chochavo/FunctionGeneratorIot/Schematics/Communication Protocol.xlsx

 | Commands - WLAN Communication Sequence
Step | Description | Command | Response | Direction
1 | ESP32 AT Commands Set | <According to Datasheet | \r\nOK\r\n | Device -> ESP32
2 | Request Wi-Fi from EEPROM | WN=S<SSID>,P<PASS>,E<ENCRYPTION>\r\n | \r\nOK\r\n | Device -> Device
 | Commands - Socket Message Handler (SMH)
 | Description | Command | Response | Direction
 | Battery Status [%] | \r\nGIVE BAT\r\n | VBAT=<VALUE>\r\n | Phone -> Device
 | AC Status | \r\nGIVE AC\r\n | AC=ON\r\n (OR) AC=OFF\r\n | Phone -> Device
 | Boot from direct mode | \r\nBOOT=DIR\r\n | \r\nOK\r\n | Phone -> Device
 | Boot from local Wi-Fi | \r\nBOOT=LAN\r\n | \r\nOK\r\n | Phone -> Device
 | Reset device | \r\nBOOT=RESET\r\n | \r\nOK\r\n | Phone -> Device
 | Factory settings | \r\nBOOT=RESTORE\r\n | \r\nOK\r\n | Phone -> Device
 | Shut down device | \r\nBOOT=SHDN\r\n | \r\nOK\r\n | Phone -> Device
 | Set LCD Brightness | \r\nLCD=B100\r\n | \r\nOK\r\n | Phone -> Device
 | Set LCD Contrast | \r\nLCD=C100\r\n | \r\nOK\r\n | Phone -> Device
 | Set Volume | \r\nVOL=100\r\n | \r\nOK\r\n | Phone -> Device
 | Commands - Set device parameter | Format | \r\nC=<CHANNEL>,<PARAMETER>="<WORD>"\r\n
 | Description | Command | Response | Direction
 | Set Bias - CH1, NEGATIVE | \r\nC=1,B="-1.00"\r\n | \r\nOK\r\n | Phone -> Device
 | Set Bias - CH0, POSITIVE | \r\nC=0,B="+2.33"\r\n | \r\nOK\r\n | Phone -> Device
 | Set Amplitude - CH1 | \r\nC=1,A="0.55"\r\n | \r\nOK\r\n | Phone -> Device
 | Set Amplitude - CH0 | \r\nC=0,A="1.00"\r\n | \r\nOK\r\n | Phone -> Device
 | Set Frequency - CH1 | \r\nC=1,F="1000000"\r\n | \r\nOK\r\n | Phone -> Device
 | Set Frequency - CH0 | \r\nC=0,F="10"\r\n | \r\nOK\r\n | Phone -> Device
 | Set Type - CH1, SINE | \r\nC=1,T="S"'\r\n | \r\nOK\r\n | Phone -> Device
 | Set Type - CH1, TRIANGLE | \r\nC=1,T="T"\r\n | \r\nOK\r\n | Phone -> Device
 | Set Type - CH1, SQUARE | \r\nC=1,T="Q'\r\n | \r\nOK\r\n | Phone -> Device
 | Set Type - CH1, DC | \r\nC=1,T="D"\r\n | \r\nOK\r\n | Phone -> Device
 | Set Type - CH1, OFF | \r\nC=1,T="O"\r\n | \r\nOK\r\n | Phone -> Device
 | Commands - Misc | Format | \r\nC=<CHANNEL>,<PARAMETER>="<WORD>"\r\n
 | Description | Command | Response | Direction
 | Reboot request for ARTIK055 | RESET\r\n | \r\nOK\r\n | Device -> Phone
 | Shutdown Sequence | SHDN\r\n | \r\nOK\r\n | Device -> Phone
