chochavo/FunctionGeneratorIot/Schematics/BOM.xls

UI Parts
 | Description | Quantity
 | 2004A Char-LCD 20x4 Blue | 1
 | USB Type B Connector | 1
 | 10 Set Mini Micro JST XH 2.54mm 4 Pin | 1
 | 6pcs Momentary SW | 1
Main PCB
 | Ref. Des. | Value | Part Number | Mouser Part Number | Quantity | Price | Ext. Price
 | C3, C8, C11, C12, C15, C16, C17, C18, C19, C20, C21, C24, C25, C26, C27, C30, C32, C35, C36, C37, C38, C39, C40, C41, C42, C43, C44 | 0.1uF | GCD21BR72A104KA01L | 81-GCD21BR72A104KA1L | 30 | 0.26 | 7.80
 | J3, J5 | X | 1-1337543-0 | 571-1-1337543-0 | 4 | 1.45 | 5.80
 | R2 | 1M | CRCW08051M13FKEA | 71-CRCW08051M13FKEA | 5 | 0.10 | 0.50
 | C1, C5, C7, C9, C13, C22, C31 | 1uF | 885012107015 | 710-885012107015 | 10 | 0.10 | 1.00
 | R1 | 3K | CR0805-FX-3321ELF | 652-CR0805FX-3321ELF | 5 | 0.10 | 0.50
 | R15, R24 | 5K6 | ERJ-6ENF5601V | 667-ERJ-6ENF5601V | 5 | 0.10 | 0.50
 | R6, R26, R27, R28, R31, R32, R33, R36, R37, R38, R43, R44, R45, R46, R47, R48, R49, R50, R51, R52, R53 | 10K | ERJ-6ENF1002V | 667-ERJ-6ENF1002V | 40 | 0.10 | 4.00
 | C14, C23 | 10nF | 885342207005 | 710-885342207005 | 5 | 0.10 | 0.50
 | C2, C4, C6 | 10uF | TAJA106M006RNJ | 581-TAJA106M006R | 6 | 0.26 | 1.56
 | R41, R42 | 20K | ESR10EZPJ203 | 755-ESR10EZPJ203 | 5 | 0.10 | 0.50
 | C28, C29 | 22pF | 885012007002 | 710-885012007002 | 5 | 0.10 | 0.50
 | R4 | 39K | ERJ-6ENF3902V | 667-ERJ-6ENF3902V | 5 | 0.10 | 0.50
 | C33, C34 | 47uF | TAJA476K006SNJV | 581-TAJA476K006SNJV | 5 | 0.53 | 2.65
 | R5 | 56K | CR0805-JW-563ELF | 652-CR0805JW-563ELF | 5 | 0.10 | 0.50
 | R29, R30 | 100K | ERJ-6ENF1003V | 667-ERJ-6ENF1003V | 5 | 0.10 | 0.50
 | R39, R40 | 100R | CRCW0805100RJNEAC | 71-CRCW0805100RJNEAC | 5 | 0.10 | 0.50
 | R25 | 180R | RC0805JR-13180RL | 603-RC0805JR-13180RL | 5 | 0.11 | 0.55
 | R8, R9, R17, R18 | 200R | CR0805-FX-2000ELF | 652-CR0805FX-2000ELF | 8 | 0.10 | 0.80
 | R13, R22 | 470R | CR0805-JW-471ELF | 652-CR0805JW-471ELF | 6 | 0.10 | 0.60
 | C10 | 470nF | 885012207020 | 710-885012207020 | 3 | 0.11 | 0.33
 | R3 | 470K | RR1220P-474-D | 754-RR1220P-474D | 3 | 0.10 | 0.30
 | R14, R23 | 820R | CRCW0805820RJNEA | 71-CRCW0805820RJNEA | 4 | 0.10 | 0.40
 | Y3 | X | ABM8AIG-16.000MHZ-12-2Z-T3 | 815-M8AIG-16-12-2ZT3 | 2 | 1.29 | 2.58
 | IC1, IC2 | X | AD9834BRUZ | 584-AD9834BRUZ | 3 | 11.09 | 33.27
 | U4 | X | ADG836LYRMZ | 584-ADG836LYRMZ | 2 | 3.28 | 6.56
 | U5 | X | ATmega32L-8AU | 556-ATMEGA32L-8AU | 2 | 5.55 | 11.10
 | Y1, Y2 | X | ECS-3953M-250-BN-TR | 520-3953M-250-BN | 3 | 2.18 | 6.54
 | J7 | X | WRL-13678 | 474-WRL-13678 | 2 | 6.95 | 13.90
 | U1 | X | LM2662MX/NOPB | 926-LM2662MX/NOPB | 2 | 2.14 | 4.28
 | U13, U17 | X | LMH6643MMX/NOPB | 926-LMH6643MMX/NOPB | 4 | 1.75 | 7.00
 | U6 | X | MAX9202EUD+ | 700-MAX9202EUD | 2 | 3.32 | 6.64
 | U7, U18, U19, U20 | X | MCP4922T-E/SL | 579-MCP4922T-E/SL | 6 | 2.70 | 16.20
 | U14 | X | MCP42100-E/SL | 579-MCP42100-E/SL | 2 | 2.24 | 4.48
 | U$3 | X | MCP73831T-2ACI/OT | 579-MCP73831T-2ACIOT | 2 | 0.58 | 1.16
 | U3 | X | STM6601AQ2BDM6F | 511-STM6601AQ2BDM6F | 2 | 1.51 | 3.02
 | U2 | X | TLV75733PDBVR | 595-TLV75733PDBVR | 2 | 0.86 | 1.72
 | J1 | X | UJ2-MIBH-4-SMT-TR | 490-UJ2-MIBH-4-SMT | 2 | 0.96 | 1.92
 | L3 | X | 742792040 | 710-742792040 | 2 | 0.22 | 0.44
ESP32 PCB
 | Value | QT | Part Number | Mouser Part Number
 | X | 2 | ESP32-WROOM-32 | ESP32-WROOM-32
 | 100uF | 2 | T520A107M006ATE045 | 80-T520A107M06ATE045
 | 5K6 | 4 | ERJ-6ENF5601V | 667-ERJ-6ENF5601V
 | 1uF | 2 | 885012107015 | 710-885012107015
 | OR | 4 | CRCW06030000Z0EBC | 71-CRCW06030000Z0EBC
Links
 | Part Number
 | https://www.ebay.com/itm/2004A-Char-LCD-20x4-Blue-Background-White-Text/283543768995
 | https://www.ebay.com/itm/USB-Type-B-Connectors-PCB-Through-Hole-Mounting-4-Pin-Socket/232355126472
 | https://www.ebay.com/itm/10-Set-Mini-Micro-JST-XH-2-54mm-4-Pin-Connector-Plug-With-24AWG-1007-Wires-15cm/274328845099
 | https://www.ebay.com/itm/6pcs-Momentary-Self-Lock-Push-Button-Round-Toggle-Switch-Wonderful-ON-OFF/352482579818
