chochavo/FunctionGeneratorIot/Schematics/Schematics.pdf

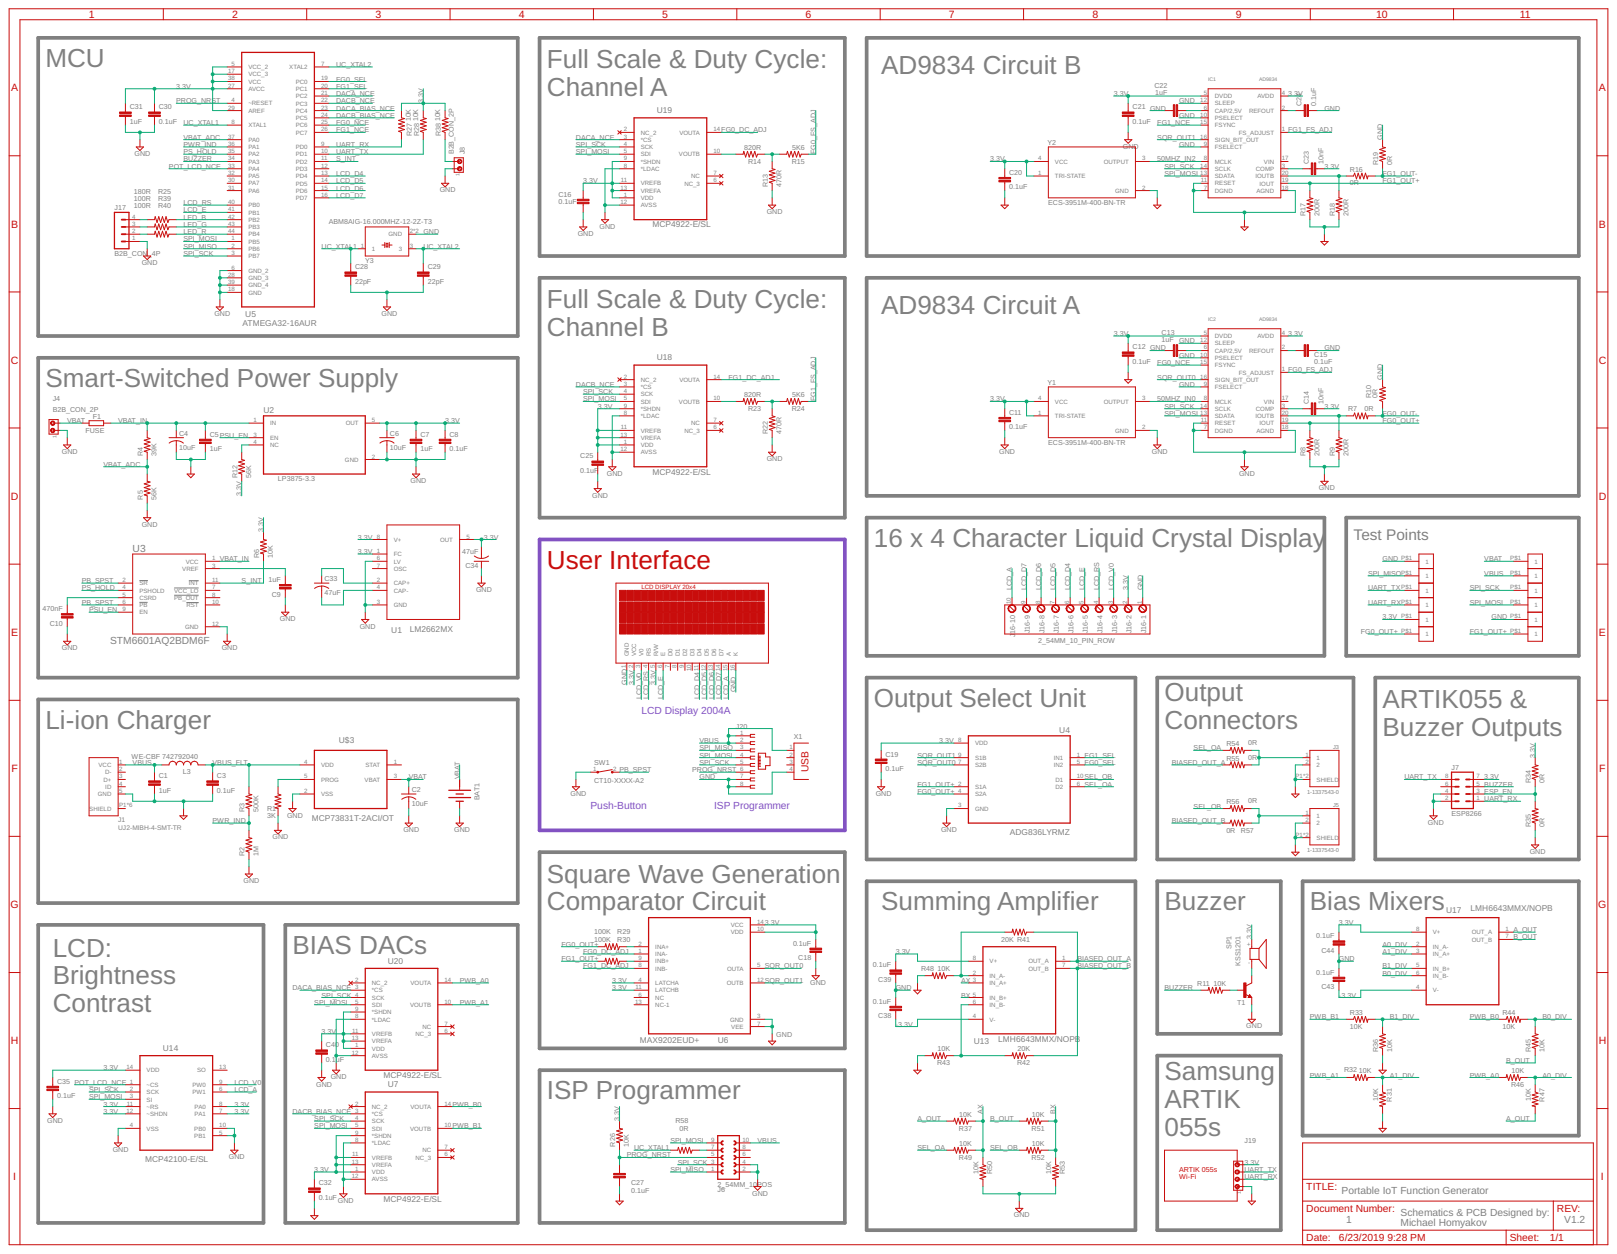
[picture p1: page 1]

Full Scale & Duty Cycle:
Channel A

Channel B

Smart-Switched Power Supply

16 x 4 Character Liquid Crystal Display
