chochavo/FunctionGeneratorIot/Code/Atmega32L/IotFuncGen/IotFuncGen/Headers/Version.h

/*
 * Version.h
 *
 * Created: 8/27/2020 11:39:14 AM
 *  Author: choch
 */ 


#ifndef VERSION_H_
#define VERSION_H_

#define FIRMWARE_VERSION_MAJOR '2'
#define FIRMWARE_VERSION_MINOR '0'
#define FIRMWARE_VERSION_BUILD '2'



#endif /* VERSION_H_ */
