chochavo/FunctionGeneratorIot/(commit log)

2020-08-15 Android V2.0 rev 0.
    [app_bar_main.xml]
2020-08-17 V2.0.1
    ESP32 support
2020-08-27 V2.1 - Encoder Implementation
2020-09-28 V2.0.2 - Final
    [BOM.xls, Communication Protocol.xlsx]
